tvixen/4KW-230V-Inverter/(threads)

Thread 2 (2023-01-25):

Relay board schematic is missing

paulsteigel, 2023-01-25:
Hi Tim,
Thank you very much for your beautiful products. I studied the advance board and found that you have connection 2 to relay board print but I could not find it in your document package. I assumed that the relay board is not needed for the Inverter (advanced version)
If it possible, please share with us the schematic and also the relay board (if needed for the inverter to work).
I am thinking on joining the Inverter with a buck converter for my home solar panels and may consider replacing nano with ESP32 wifi can also work.
Please advise me with thanks.
Yours very faithfully,
Dang Dinh Ngoc

tvixen, 2023-01-27:
Hi Dang
You are right, the relay board is not necessary but only a safety device that facilitates the timing of the charge and discharge for the the large electrolytes. It can charge them and discharge them with resistors and relays.
I haven't any schematics for the relay board, but its very simple to make for other engineers.

Replacing the nano with a ESP32 is a good idea, as it have a more powerfull cpu.

chetosvsgeez, 2023-05-18:
Sorry Tvixen I am again, you could provide me with a couple of things, with which program you made the PCBs, I know that it has no component list, but a photo of the end of the project, and an image with more resolution of the investor's scheme To try to export it to Kicad
I have already received the PCBs, the EGS002, the power supply
I only have to collect the components
For that, I need help and advice
sorry for my english

Closed 2023-01-27.

Thread 3 (2023-04-30):

Materials Electronic PCB

chetosvsgeez, 2023-04-30:
Good afternoon you would have the list of electronic components of the three plates

tvixen, 2023-04-30:
Sorry no BOM list .... As thers so few components.

chetosvsgeez, 2023-05-11:
You could supply photos of the final assembly, there is a possibility of managing two series investors
Podias suministrar fotos del montaje final, hay posibilidad de gestionar dos inversores en serie
I want to ride two and try to communicate them with my axper King 5kw 48v
Quiero montar dos y intentar comunicarlos con mi axper king 5kw 48V

chetosvsgeez, 2023-05-11:
Thank you for your work

tvixen, 2023-05-11:
Your welcome.

Closed 2023-05-01.

Thread 4 (2023-05-18):

Montaje de inversor

chetosvsgeez, 2023-05-18:
Sorry Tvixen I am again, you could provide me with a couple of things, with which program you made the PCBs, I know that it has no component list, but a photo of the end of the project, and an image with more resolution of the investor's scheme To try to export it to Kicad
I have already received the PCBs, the EGS002, the power supply
I only have to collect the components
For that, I need help and advice
sorry for my english

tvixen, 2023-05-30:
Thats a good ide, trying to port it to Kicad.
I used an old Protel program. But I don't own the license anymore. As this was bought 10 years ago.

chetosvsgeez, 2023-07-04:
You could send me the raw files of Protel, and the image of the PBC finished, now in summer I have more time to dedicate myself to it.
Thanks again

Thread 5 (2024-04-17):

1.2Kw with 4 Mosfet

zero48, 2024-04-17:
Hello, Would a 1X4 Mosfet manage 1.2kw? instead of 2X4 Mosfet as your 4KW?
I'm working on Kicad 7 . Would be possible to get the protel for the Power section ?
Thanks for this wonderful Share .
Thanks in advance
Zero48

tvixen, 2024-04-17:
Hi there,
No it will not be possible just to use 4 mosfet's

zero48, 2024-04-18:
Thanks very mu

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

zero48, 2024-04-18:
Last question , Which transformer did you use (EI or Toroidal) ?
it was a secondary 26 VAC (no center tap)  to  primary 220VAC? .
Thanks once again

tvixen, 2024-04-19:
A Toroidal ... normal toroidal 15A, but modified the windings on the secondary side.
