tvixen/4KW-230V-Inverter/230V Inverter/Advanced/Cheap Inverter Controller with SCR 1.1.Sch .pdf

A

A

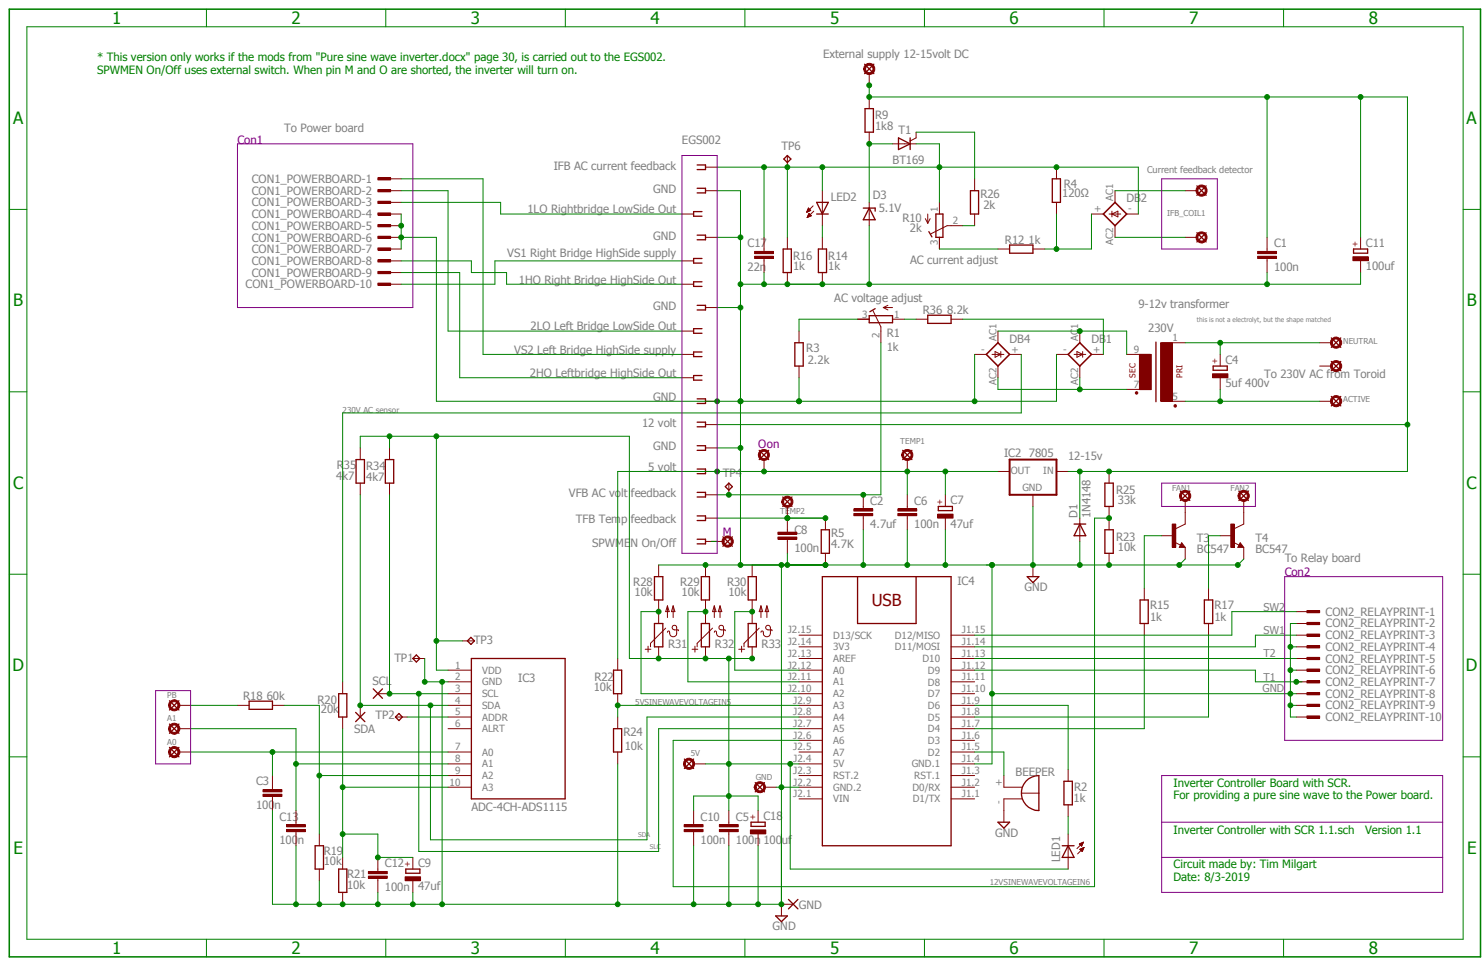
[picture p21: page 1]

* This version only works if the mods from "Pure sine wave inverter.docx" page 30, is carried out to the EGS002.
SPWMEN On/Off uses external switch. When pin M and O are shorted, the inverter will turn on.

IFB AC current feedback

VS1 Right Bridge HighSide supply

1HO Right Bridge HighSide Out

2LO Left Bridge LowSide Out

this is not a electrolyt, but the shape matched

VS2 Left Bridge HighSide supply

To 230V AC from Toroid

12 volt

TEMP2

ALRT 6

Inverter Controller Board with SCR.
For providing a pure sine wave to the Power board.

Inverter Controller with SCR 1.1.sch Version 1.1

Circuit made by: Tim Milgart
Date: 8/3-2019
