tvixen/4KW-230V-Inverter/230V Inverter/Basic/Pure sinewave inverter 4KW - Controller board rev.09 PCB.pdf

IFB | adjust
+V | -V

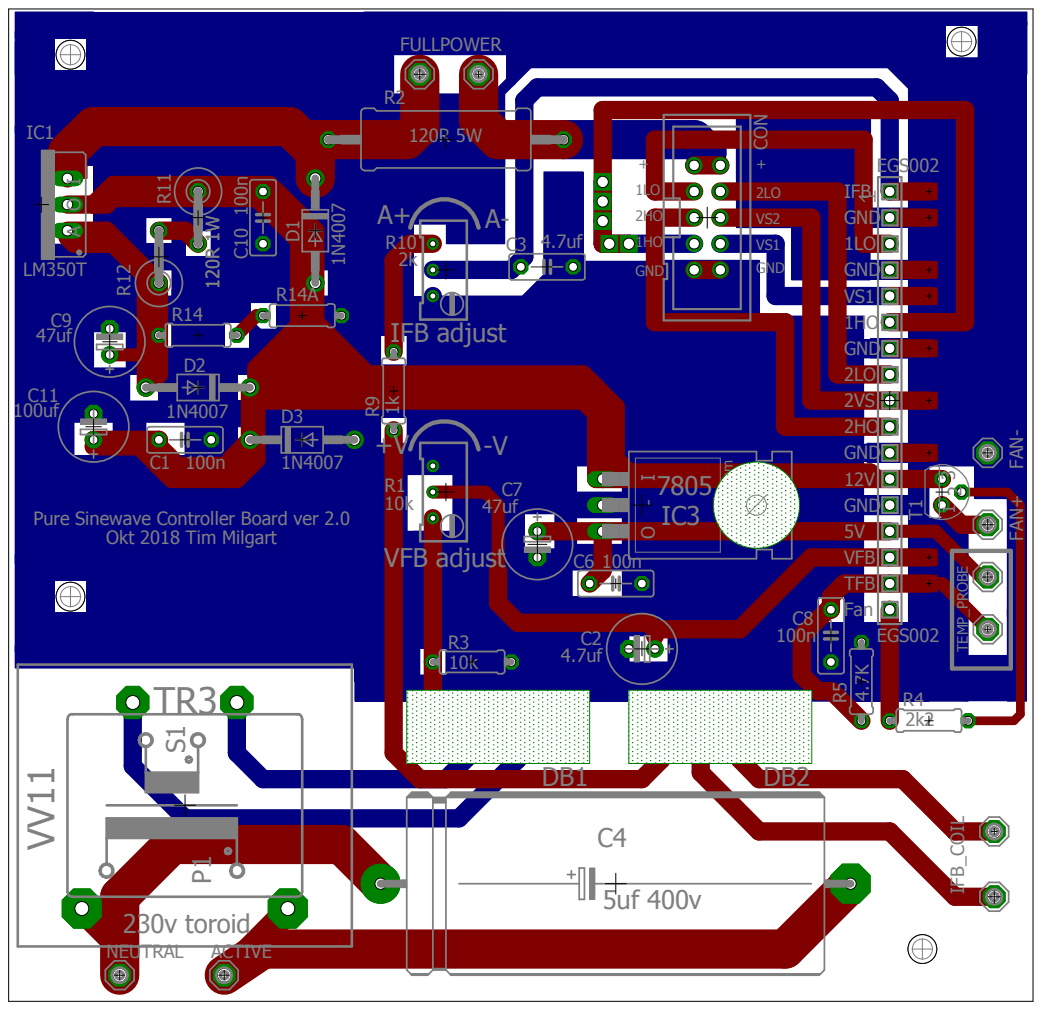
[picture p22: page 1]

Pure Sinewave Controller Board ver 2.0
