tvixen/4KW-230V-Inverter/230V Inverter/Basic/Pure sinewave inverter 4KW - Controller board rev.09.pdf

A

A

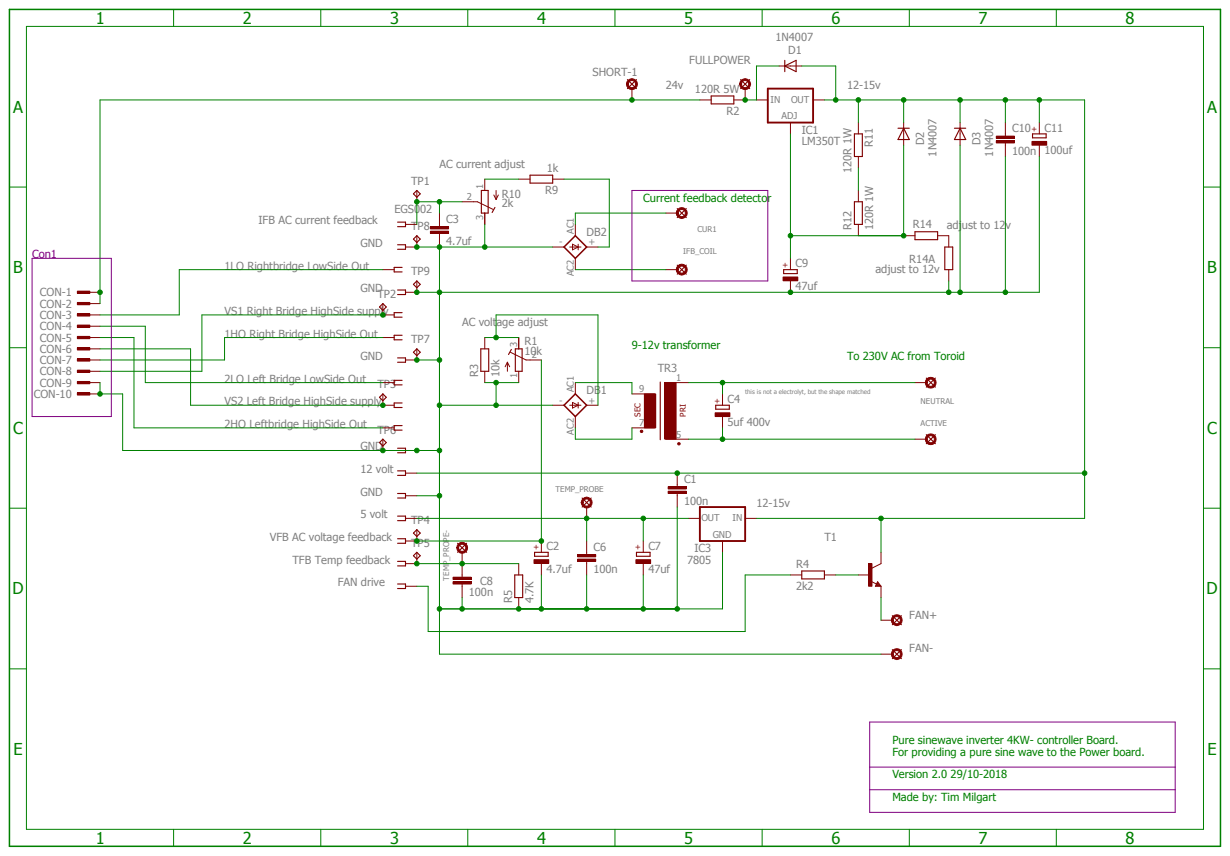
[picture p23: page 1]

IFB AC current feedback

VS1 Right Bridge HighSide supply

1HO Right Bridge HighSide Out

To 230V AC from Toroid

2LO Left Bridge LowSide Out

VS2 Left Bridge HighSide supply

this is not a electrolyt, but the shape matched

VFB AC voltage feedback

Pure sinewave inverter 4KW- controller Board.
For providing a pure sine wave to the Power board.

Made by: Tim Milgart
