tvixen/4KW-230V-Inverter/230V Inverter/doc/download/Cheap Inverter Controller with SCR 1.1.PCB.pdf

1 | 3 | 7 | 9
2 | 4 | 6 | 8 10

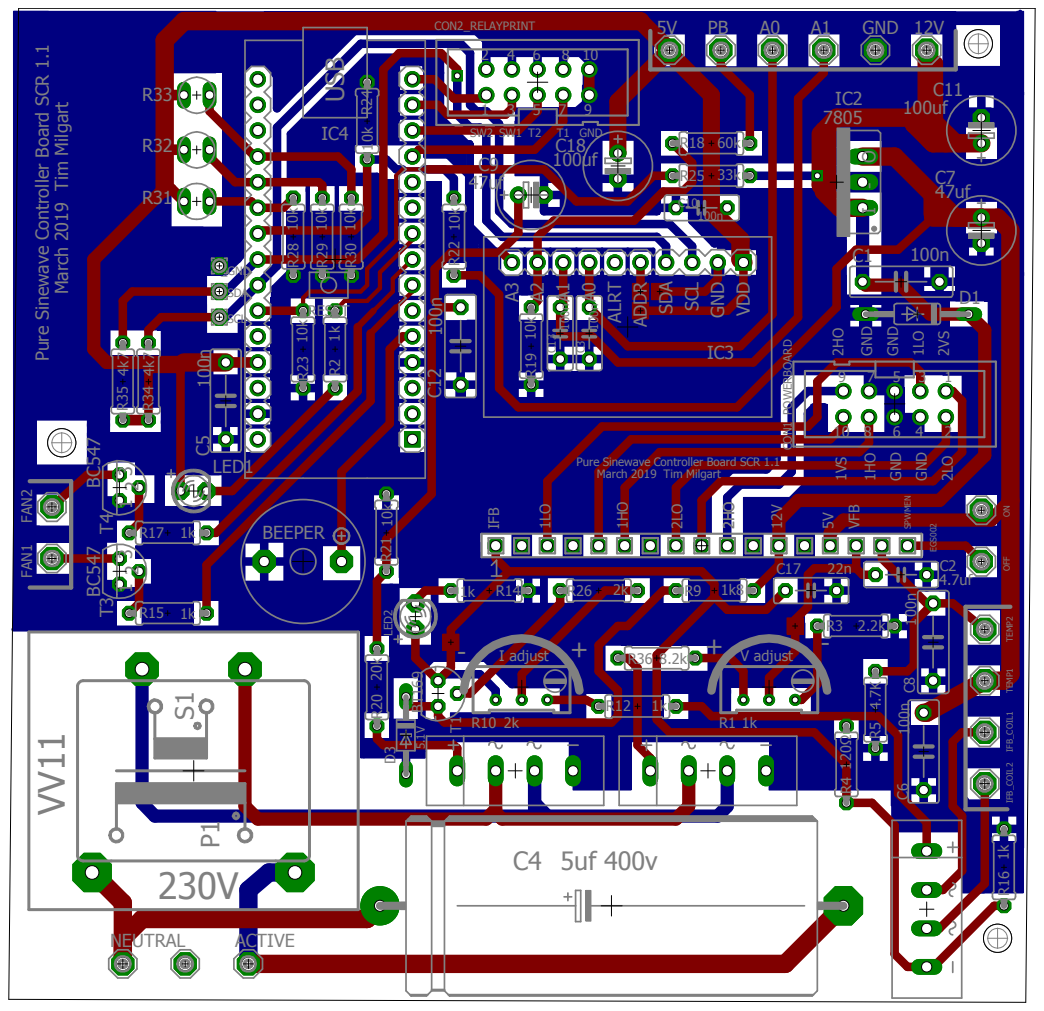
[picture p24: page 1]

Pure Sinewave Controller Board SCR 1.1

March 2019 Tim Milgart
