tvixen/4KW-230V-Inverter/230V Inverter/doc/download/Filter PCB.pdf

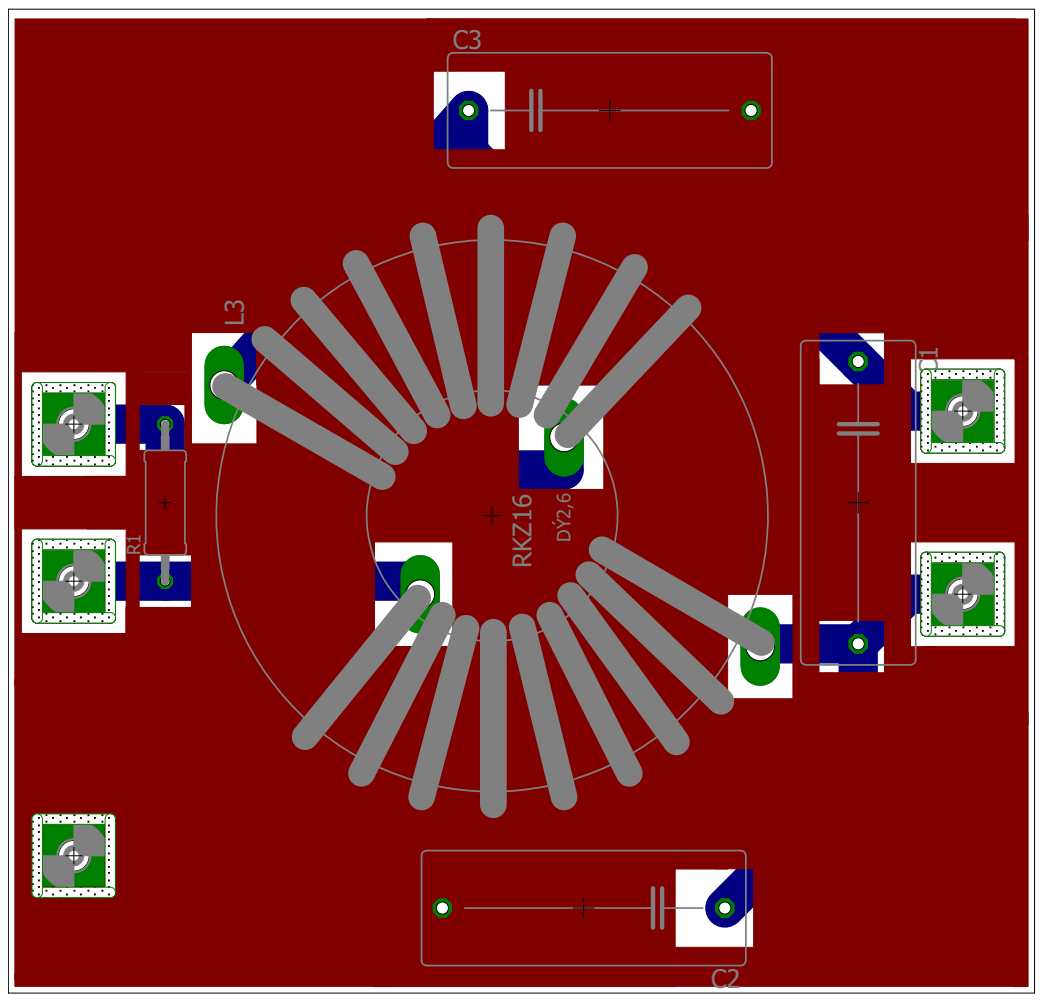
[picture p25: page 1]
