tvixen/4KW-230V-Inverter/230V Inverter/doc/download/Inverter power board 3.8.PCB.pdf

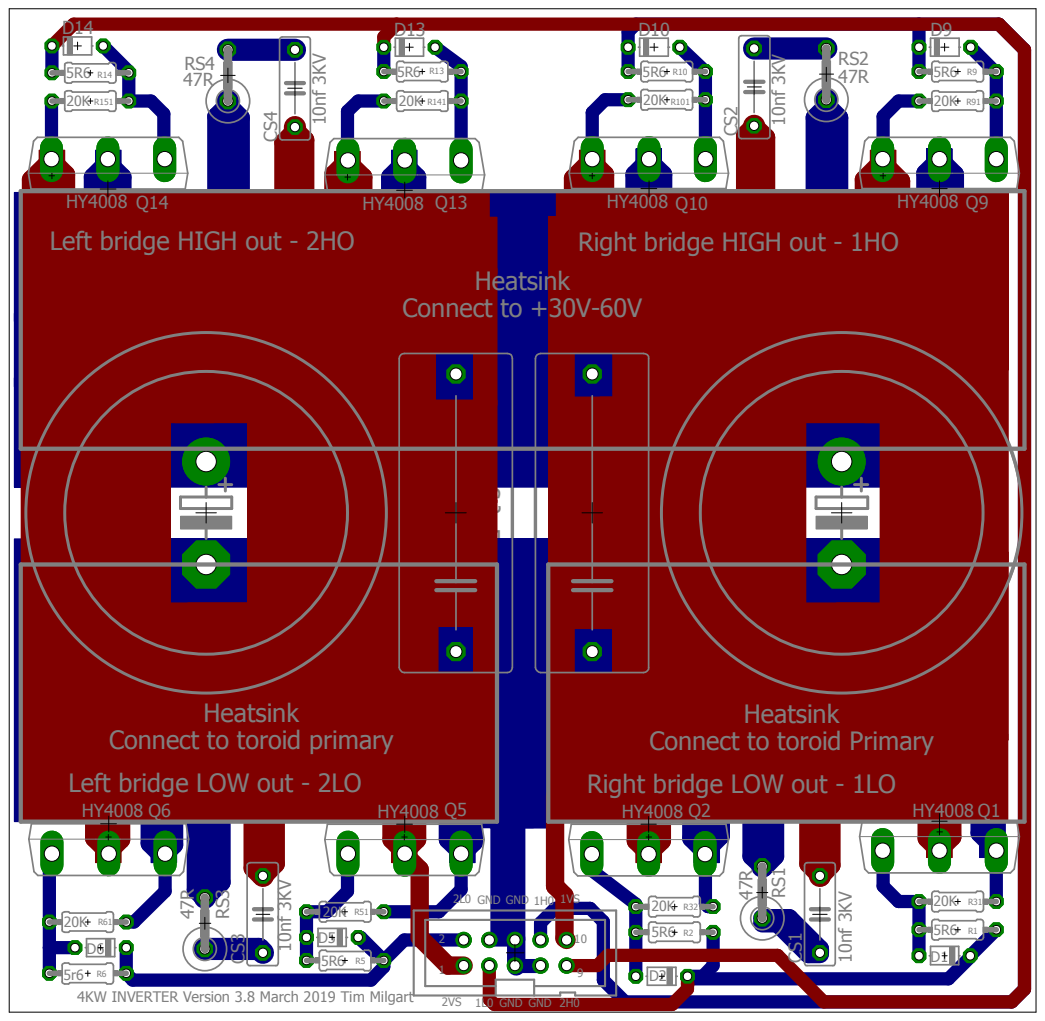
[picture p26: page 1]

Left bridge HIGH out - 2HO

Connect to toroid primary
Left bridge LOW out - 2LO

Connect to toroid Primary
